beagleboard/robotics-cape/(threads)

Thread 2 (2021-11-23):

Header pin concerns

jadonk, 2021-11-23:
Reply here with any header pin concerns to consolidate them.

* P8_21/P8_33 have only PRU UART, not ARM UART, so a driver and firmware would need to be written.
* P8_24 does not have UART2 for GPS_RXD.

jadonk, 2021-12-21:
I am *SO* confused by the pin selection. It seems that the previous Robotics Cape pinout was completely missed and nothing could ever be compatible with BeagleBone Black.

https://github.com/beagleboard/capes/tree/master/beaglebone/Robotics

Thread 4 (2021-11-23):

4-pin connectors could be Grove

jadonk, 2021-11-23:
I thought we agreed the QEP and Ultrasonic connectors could be Grove. There's no good need for them to be small anymore with the new size of the board, so I think we can enlarge to Grove connectors.

Closed 2022-02-06.

Thread 5 (2021-11-23):

Schematic pin header numbers don't match BBAI

jadonk, 2021-11-23:
The pin numbers should be changed to match.

jadonk, 2022-02-06:
Please fix this.

Thread 6 (2021-11-23):

Cape EEPROM

jadonk, 2021-11-23:

linyuxuanlin, 2021-12-01:
scl, sda is re-used with Barometer_CS, SPI1_SDI. EEPROM I2C can not work.

Thread 10 (2021-12-01):

USB hub

linyuxuanlin, 2021-12-01:
USB can not enumerate peripherals. No pull-up resistor for USB hub dp.

jadonk, 2022-04-05:
Revision 0.6 also does not work.

jadonk, 2022-04-07:
The issue was with the particular AI-64 board.

Closed 2022-04-07.

Thread 12 (2021-12-01):

Misoperation protection

linyuxuanlin, 2021-12-01:
Add anti-reverse protection for battery connector.

Thread 13 (2021-12-01):

Motor silkscreen

linyuxuanlin, 2021-12-01:
Motor 2/3/4 silkscreen is wrong.

Thread 7 (2021-12-01):

Motor over-current protection

linyuxuanlin, 2021-12-01:
When motor 2/3/4 is over-current protected, it can not be reset. It needs nSleep signal for reset. But the schematic design do not have nSleep signal.

Thread 9 (2021-12-01):

USB power switch

linyuxuanlin, 2021-12-01:
Use the wrong USB power switch.

Thread 19 (2021-12-08):

eQEP doesn't work

mingzhangqun, 2021-12-08:
config:
https://github.com/mingzhangqun/BeagleBoard-DeviceTrees/commit/04c1ba7bc28e5279bef8331f263dd7f7e5487e15

test:
```
# QEP - enable
root@BeagleBone:# echo 312 > /sys/class/gpio/export
root@BeagleBone:# echo out > /sys/class/gpio/gpio312/direction
root@BeagleBone:# echo 0 > /sys/class/gpio/gpio312/value

root@BeagleBone:/sys/bus/counter/devices/counter0/count0# echo 1 > enable
root@BeagleBone:/sys/bus/counter/devices/counter0/count0# watch -n 0.1 cat count

root@BeagleBone:/sys/bus/counter/devices/counter1/count0# echo 1 > enable
root@BeagleBone:/sys/bus/counter/devices/counter1/count0# watch -n 0.1 cat count
```

I can't get the value of the counter when the motor is running.

Thread 20 (2022-01-05):

Pinout

jadonk, 2022-01-05:
Pinout would be much better if kept largely compatible with the previous Robotics Cape!!!

https://github.com/beagleboard/capes/tree/master/beaglebone/Robotics

jadonk, 2022-01-05:
The pins used on that board have compatible UART/PWM/I2C/SPI locations used across many BeagleBone boards. By choosing other locations for UART/PWM/I2C/SPI, much compatibility is broken. BeagleBone AI-64 header pins were chosen to match this board.

jadonk, 2022-01-05:
cc @mingzhangqun @linyuxuanlin

jadonk, 2022-04-05:
New pinout....

<google-sheets-html-origin><style type="text/css"><!--td {border: 1px solid #ccc;}br {mso-data-placement:same-cell;}--></style>

Function | Pin | IO Category | Compatible with BBB | Recommended header pin | BBB function | BBAI function
-- | -- | -- | -- | -- | -- | --
Motor1 | Motor1_PWM | PWM | NO | P9_14 | PWM | PWM
Motor1 | Motor1_IN1 | IO | YES（GPIO） | P9_13 | GPIO | GPIO
Motor1 | Motor1_IN2 | IO | YES（GPIO） | P8_08 | GPIO | GPIO
Motor1 | Motor1_SLP# | IO | YES（GPIO） | P8_45 | GPIO | GPIO
Motor1 | Motor1_FAULT# | IO | YES（GPIO） | P8_05 | Do not have function | GPIO
Motor1 | Motor1_OC# | IO | YES（GPIO） | P8_25 | Do not have function | GPIO
Motor1 | Motor1_CLMT | IO | YES（GPIO） | P8_21 | Do not have function | GPIO
Motor1 | Motor1_Current | AIN | YES | P9_40 | AIN | AIN
Motor2/3/4 | Motor2_PWM | PWM | NO | P9_16 | PWM | PWM
Motor2/3/4 | Motor2_IN1 | IO | YES（GPIO） | P8_18 | GPIO | GPIO
Motor2/3/4 | Motor2_IN2 | IO | YES（GPIO） | P9_18 | GPIO | GPIO
Motor2/3/4 | Motor2_IPROPI | AIN | YES | P9_33 | AIN | AIN
Motor2/3/4 | Motor2_FAULT# | IO | YES（GPIO） | P8_22 | Do not have function | GPIO
Motor2/3/4 | Motor3_PWM | PWM | NO | P8_19 | PWM | PWM
Motor2/3/4 | Motor3_IN1 | IO | YES（GPIO） | P8_10 | GPIO | GPIO
Motor2/3/4 | Motor3_IN2 | IO | YES（GPIO） | P8_12 | GPIO | GPIO
Motor2/3/4 | Motor3_IPROPI | AIN | YES | P9_35 | AIN | AIN
Motor2/3/4 | Motor3_FAULT# | IO | YES（GPIO） | P8_23 | Do not have function | GPIO
Motor2/3/4 | Motor4_PWM | PWM | NO | P8_13 | PWM | PWM
Motor2/3/4 | Motor4_IN1 | IO | YES（GPIO） | P8_17 | GPIO | GPIO
Motor2/3/4 | Motor4_IN2 | IO | YES（GPIO） | P8_26 | GPIO | GPIO
Motor2/3/4 | Motor4_IPROPI | AIN | YES | P9_36 | AIN | AIN
Motor2/3/4 | Motor4_FAULT# | IO | YES（GPIO） | P8_03 | Do not have function | GPIO
Motor2/3/4 | Motor2/3/4_nSLEEP | IO | YES（GPIO） | P8_34 | GPIO | GPIO
LED | LED1 | IO | YES（GPIO） | P9_12 | GPIO | GPIO
LED | LED2 | IO | YES（GPIO） | P9_11 | GPIO | GPIO
LED | LED3 | IO | YES（GPIO） | P8_46 | GPIO | GPIO
LED | LED4 | IO | YES（GPIO） | P8_31 | GPIO | GPIO
BC | BC_TXD | UART | NO | P8_37 | UART_TX | UART_TX
BC | BC_RXD | UART | NO | P8_38 | UART_RX | UART_RX
BC | BC_RST | IO | YES（GPIO） | P8_32 | GPIO | GPIO
CAPTURE | CAP1 | ECAP | YES | P8_16 | PRU0_IN | PRU0_0_IN
CAPTURE | CAP2 | ECAP | YES | P8_15 | PRU0_IN | PRU0_0_IN
CAPTURE | CAP3 | ECAP | YES | P9_28 | PRU0_IN | PRU0_0_IN
CAPTURE | CAP4 | ECAP | YES | removed | \ | \
CAPTURE | CAP_OE1# | IO | YES（GPIO） | P9_15 | GPIO | GPIO
QEP | QEP1_A | EQEP | YES | P9_42 | QEP_A |  
QEP | QEP1_B | EQEP | YES | P9_27 | QEP_B |  
QEP | QEP2_A | EQEP | YES | P8_35 | QEP_A |  
QEP | QEP2_B | EQEP | YES | P8_33 | QEP_B |  
QEP | CAP_OE2# | IO | YES（GPIO） | removed | \ | \
Ultrasonic | Ultrasonic1 | IO | YES（GPIO） | P8_11 | GPIO | GPIO
Ultrasonic | Ultrasonic2 | IO | YES（GPIO） | P8_09 | GPIO | GPIO
Ultrasonic | Ultrasonic3 | IO | YES（GPIO） | P9_38 | GPIO | GPIO
Ultrasonic | Ultrasonic4 | IO | YES（GPIO） | P8_36 | GPIO | GPIO
Lidar | Lidar_PWM | PWM | NO | P8_07 | TIMER | PRU1_0_OUT
Lidar | Lidar_OE | IO | YES（GPIO） | P8_14 | GPIO | GPIO
Lidar | Lidar_TX | UART | NO | P9_21 | UART_TX | PRU1_1_OUT (soft UART)
Lidar | Lidar_RX | UART | NO | P9_22 | UART_RX | PRU1_1_IN (soft uart)
Servo | Servo1 | PWM | YES | P8_27 | PRU1_OUT | PRU0_0_OUT
Servo | Servo2 | PWM | NO | P8_28 | PRU1_OUT | PRU0_0_OUT
Servo | Servo3 | PWM | YES | P8_29 | PRU1_OUT | PRU0_0_OUT
Servo | Servo4 | PWM | NO | P8_30 | PRU1_OUT | PRU0_0_OUT
Servo | Servo5 | PWM | NO | P8_39 | PRU1_OUT | PRU0_1_OUT
Servo | Servo6 | PWM | NO | P8_40 | PRU1_OUT | PRU0_1_OUT
Servo | Servo7 | PWM | NO | P8_41 | PRU1_OUT | PRU0_1_OUT
Servo | Servo8 | PWM | NO | P8_42 | PRU1_OUT | PRU0_1_OUT
Servo | Servo9 | PWM | NO | P8_43 | PRU1_OUT | PRU0_1_OUT
Servo | Servo10 | PWM | NO | P8_44 | PRU1_OUT | PRU0_1_OUT
6-DOF Sensor(SPI) | 6DOF_CS# | IO | YES（GPIO） | P9_23 | GPIO | GPIO
6-DOF Sensor(SPI) | 6DOF_INT | IO | YES（GPIO） | P8_24 | Do not have function | GPIO
Compass(SPI) | CPSS_CS# | IO | YES（GPIO） | P9_25 | GPIO | GPIO
Compass(SPI) | CPSS_INT | IO | YES（GPIO） | P8_06 | Do not have function | GPIO
Barometer(SPI) | Barometer_CS# | IO | YES | P9_17 | GPIO | GPIO
SPI | SPI1_SCK | SPI | YES | P9_31 | SPI_SCK | SPI_SCK
SPI | SPI1_SDO | SPI | YES | P9_30 | SPI_MOSI | SPI_MOSI
SPI | SPI1_SDI | SPI | YES | P9_29 | SPI_MISO | SPI_MISO
USB_HUB | USB_HUB_D_P | USB | YES | \ | \ | \
USB_HUB | USB_HUB_D_N | USB | YES | \ | \ | \
USB_HUB | RESETSTATZ | USB | YES | P9_10 | RESET | RESET
USER_BUTTON | USER_BUTTON1 | IO | YES | P9_37 | GPIO | GPIO
USER_BUTTON | USER_BUTTON2 | IO | YES（GPIO） | P9_41 | GPIO | GPIO
GPS | GPS_TXD | UART | NO | P9_24 | UART_TX | UART_TX
GPS | GPS_RXD | UART | NO | P9_26 | UART_RX | UART_RX
Battery_Voltage | Battery_Voltage | AIN | YES | P9_39 | AIN | AIN
EEPROM | EEPROM_SCL | I2C | YES | P9_19 | I2C_SCL | I2C_SCL
EEPROM | EEPROM_SDA | I2C | YES | P9_20 | I2C_SDA | I2C_SDA

Thread 21 (2022-02-02):

Car: Need clearance for superspeed USB sticks

jadonk, 2022-02-02:
The front-facing ultrasonic sensor must be removed to reach the USB connectors for a typical sized superspeed USB stick. This will be used for gathering training data to the main computer.

Possible solutions:
* Perhaps the AI-64/cape sub-assembly can be rotated 90 degrees? If so, access to the buttons and status LEDs within the enclosure is desired.
* Perhaps the front-facing ultrasonic sensor could be snap-mounted for easy removal?

Thread 22 (2022-02-02):

Car: cover for AI-64 5V DC input

jadonk, 2022-02-02:
An insert on the AI-64 5V DC input should be provided to avoid accidentally connecting the 12V supply to the wrong jack.

Additionally, a 12V label should be put on the Robotics Cape similar to the 5V label on the AI-64.

jadonk, 2022-04-07:
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

Thread 25 (2022-02-06):

LED1 should be green

jadonk, 2022-02-06:

lorforlinux, 2022-10-11:
Shouldn't this be red for indicating 25%?

|        Indicator      | Battery %  |  Color |
|------------|--------------|---------|
| LED1    | 25%         | Red   |
| LED2    | 50%         | Green   |
| LED3    | 75%         | Green   |
| LED4    | 100%         | Green   |

jadonk, 2022-10-12:
I think you are right. The idea of charlieplexing is good with pru firmware
and a linux leds driver.

On Tue, Oct 11, 2022 at 4:25 PM Deepak Khatri ***@***.***>
wrote:

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

Thread 26 (2022-02-06):

LED3 should be lableled "25%"

jadonk, 2022-02-06:
This is used a the battery 25% indicator.

Please see https://github.com/beagleboard/capes/tree/master/beaglebone/Robotics that this cape replaces.

Thread 27 (2022-02-06):

LED4 should be labled "75%" and should be green

jadonk, 2022-02-06:
This led is used at the battery 75% full indicator.

Ideally, there would be 50% and 100% indicators as well, but we seem to be out of I/O pins.

See https://github.com/beagleboard/capes/tree/master/beaglebone/Robotics that this cape replaces.

jadonk, 2022-10-12:
Yes, simply due to a lack of LEDs. Your idea of charlieplexing is good, but
we should do a PRU firmware load for that and an associated leds driver.

On Tue, Oct 11, 2022 at 4:50 PM Deepak Khatri ***@***.***>
wrote:

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

Thread 28 (2022-02-06):

Need UART connections for BCF_RXD/BCF_TXD

jadonk, 2022-02-06:
The last revision worked, but the latest revision has the pins connected to only a PRU UART. That cannot work. They need to be on a main or wakeup UART.

Please prefer connections specified by https://elinux.org/Beagleboard:BeagleBone_cape_interface_spec#UART.

jadonk, 2022-02-06:
Ugh. I just realized the pins are still labeled wrong. I'll start my overlay over again.

lorforlinux, 2022-10-11:
@jadonk This seems to be fixed with v0.7 of the cape.
Current board uses `/dev/bone/uart/5` pins from our cape compatibility layer.

Thread 29 (2022-02-07):

Motor2_PWM can't control

mingzhangqun, 2022-02-07:
PRU firmware:
https://github.com/mingzhangqun/cloud9-examples/tree/bbai64-cape
DTS:
https://github.com/mingzhangqun/BeagleBoard-DeviceTrees/tree/v5.10.x-ti-arm64-dev
robotic_demo:
https://github.com/mingzhangqun/robotic_demo/tree/main-dev

```
debian@BeagleBone:~/cloud9-examples/BeagleBone/AI-64/pru$ sudo make blinkR30
```
```
debian@BeagleBone:~/robotic_demo$ make
Please select pwm chs[0-14]:(0,1,2,3...)
1
Selected:0x0002
('q' - exit, '+' - inc, '-' - dec, 'r' - run/stop)
sh: 1: echo: echo: I/O error
sh: 1: echo: echo: I/O error
sh: 1: echo: echo: I/O error
+
duty=100
r
ctrl=1
```
Motor2 PWM cannot be controlled, other channels are fine.

jadonk, 2022-02-08:
Is the 0.6 version of the schematics the latest? I'm not understanding some of the behavior myself, including something as simple as controlling LED1 and LED2.

mingzhangqun, 2022-02-08:
> Is the 0.6 version of the schematics the latest? I'm not understanding some of the behavior myself, including something as simple as controlling LED1 and LED2.

Yes, the 0.6 is the latest.
What's your meaning of the behavior? the hardware or software?

jadonk, 2022-02-08:
I cannot toggle LED1 and LED2 signals. I have a boot issue now, but hope to resolve that this morning.

mingzhangqun, 2022-02-09:
```
root@BeagleBone:/sys/class/leds# echo 1 > beaglebone\:green\:cape0/brightness
root@BeagleBone:/sys/class/leds# echo 1 > beaglebone\:green\:cape1/brightness
root@BeagleBone:/sys/class/leds# echo 1 > beaglebone\:green\:cape2/brightness
root@BeagleBone:/sys/class/leds# echo 1 > beaglebone\:green\:cape3/brightness
```

jadonk, 2022-02-11:
I meant LED1/LED2 on the cape. I fixed it with recent patches at https://github.com/jadonk/BeagleBoard-DeviceTrees/tree/ai64

I'm going to try Motor2 again soon (probably tomorrow morning), but I wanted to try to understand why my interface had issues. I had forgotten that PIN_OUTPUT in the device tree simply disables the input. It seems it also had some impact on being able to configure for gpio output as well somehow. I'm trying to determine if there was a conflict driven or a lack of GPIO enabled on one of your pins needed for Motor2.
