beagleboard/robotics-cape/Cape V0.6/Robotics Cape Rev2 v0.6..pdf

# Aug. 16 2021

# REVISION

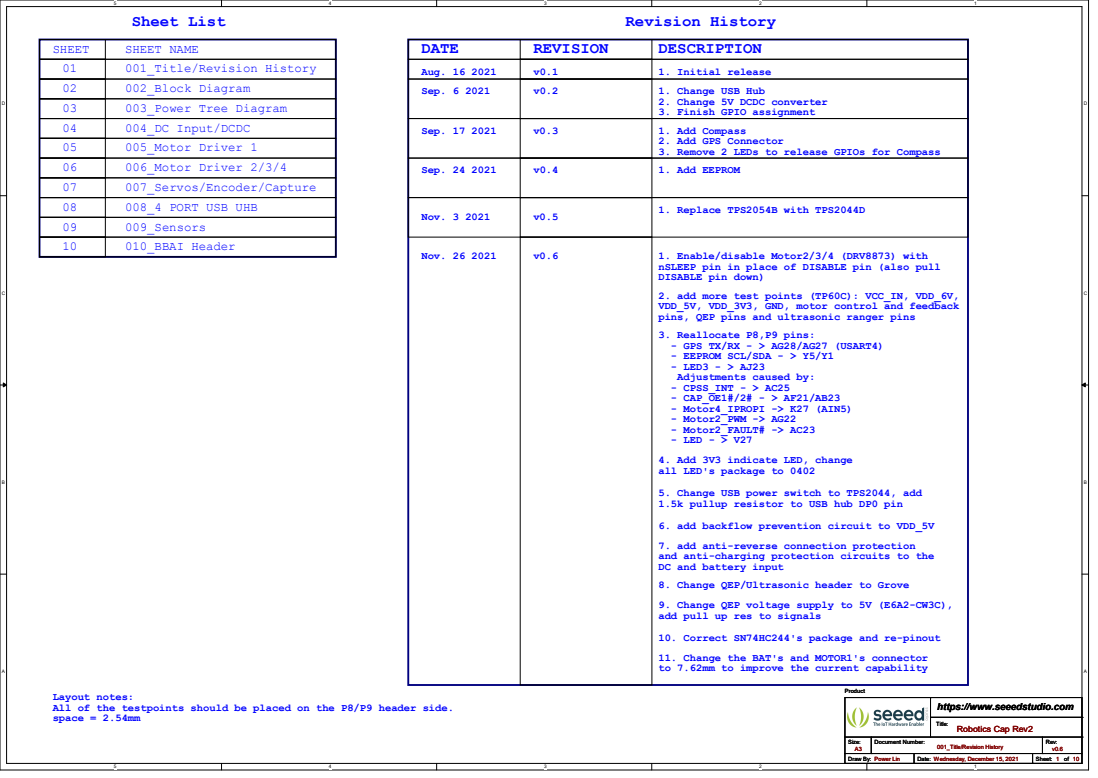
[picture p1: page 1]
DESCRIPTION; 1. Initial release; DATE; Revision History; SHEET; SHEET NAME; Sheet List; 07 08 09 009_Sensors 10 010_BBAI Header; Sep. 6 2021; 1. Change USB Hub; Sep. 17 2021; 1. Add Compass; Sep. 24 2021; 1. Add EEPROM v0.4; Nov. 3 2021; 1. Replace TPS2054B with TPS2044D; Nov. 26 2021; 1. Enable/disable Motor2/3/4 (DRV8873) with; to 7.62mm to improve the current capability; Title: Size:; Document Number:; Rev: Draw By:; Date:; Sheet:; https://www.seeedstudio.com A3; v0.6 Power Lin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

001_Title/Revision History
002_Block Diagram
003_Power Tree Diagram
004_DC Input/DCDC
005_Motor Driver 1
006_Motor Driver 2/3/4
007_Servos/Encoder/Capture
008_4 PORT USB UHB

2. Change 5V DCDC converter
3. Finish GPIO assignment

2. Add GPS Connector
3. Remove 2 LEDs to release GPIOs for Compass

nSLEEP pin in place of DISABLE pin (also pull
DISABLE pin down)
2. add more test points (TP60C): VCC_IN, VDD_6V,
VDD_5V, VDD_3V3, GND, motor control and feedback
pins, QEP pins and ultrasonic ranger pins
3. Reallocate P8,P9 pins:
- GPS TX/RX - > AG28/AG27 (USART4)
- EEPROM SCL/SDA - > Y5/Y1
- LED3 - > AJ23
Adjustments caused by:
- CPSS_INT - > AC25
- CAP_OE1#/2# - > AF21/AB23
- Motor4_IPROPI -> K27 (AIN5)
- Motor2_PWM -> AG22
- Motor2_FAULT# -> AC23
- LED - > V27
4. Add 3V3 indicate LED, change
all LED's package to 0402

5. Change USB power switch to TPS2044, add
1.5k pullup resistor to USB hub DP0 pin

6. add backflow prevention circuit to VDD_5V
7. add anti-reverse connection protection
and anti-charging protection circuits to the
DC and battery input
8. Change QEP/Ultrasonic header to Grove
9. Change QEP voltage supply to 5V (E6A2-CW3C),
add pull up res to signals

10. Correct SN74HC244's package and re-pinout
11. Change the BAT's and MOTOR1's connector

Layout notes:
All of the testpoints should be placed on the P8/P9 header side.
space = 2.54mm

001_Title/Revision History Product

# System Block Diagram

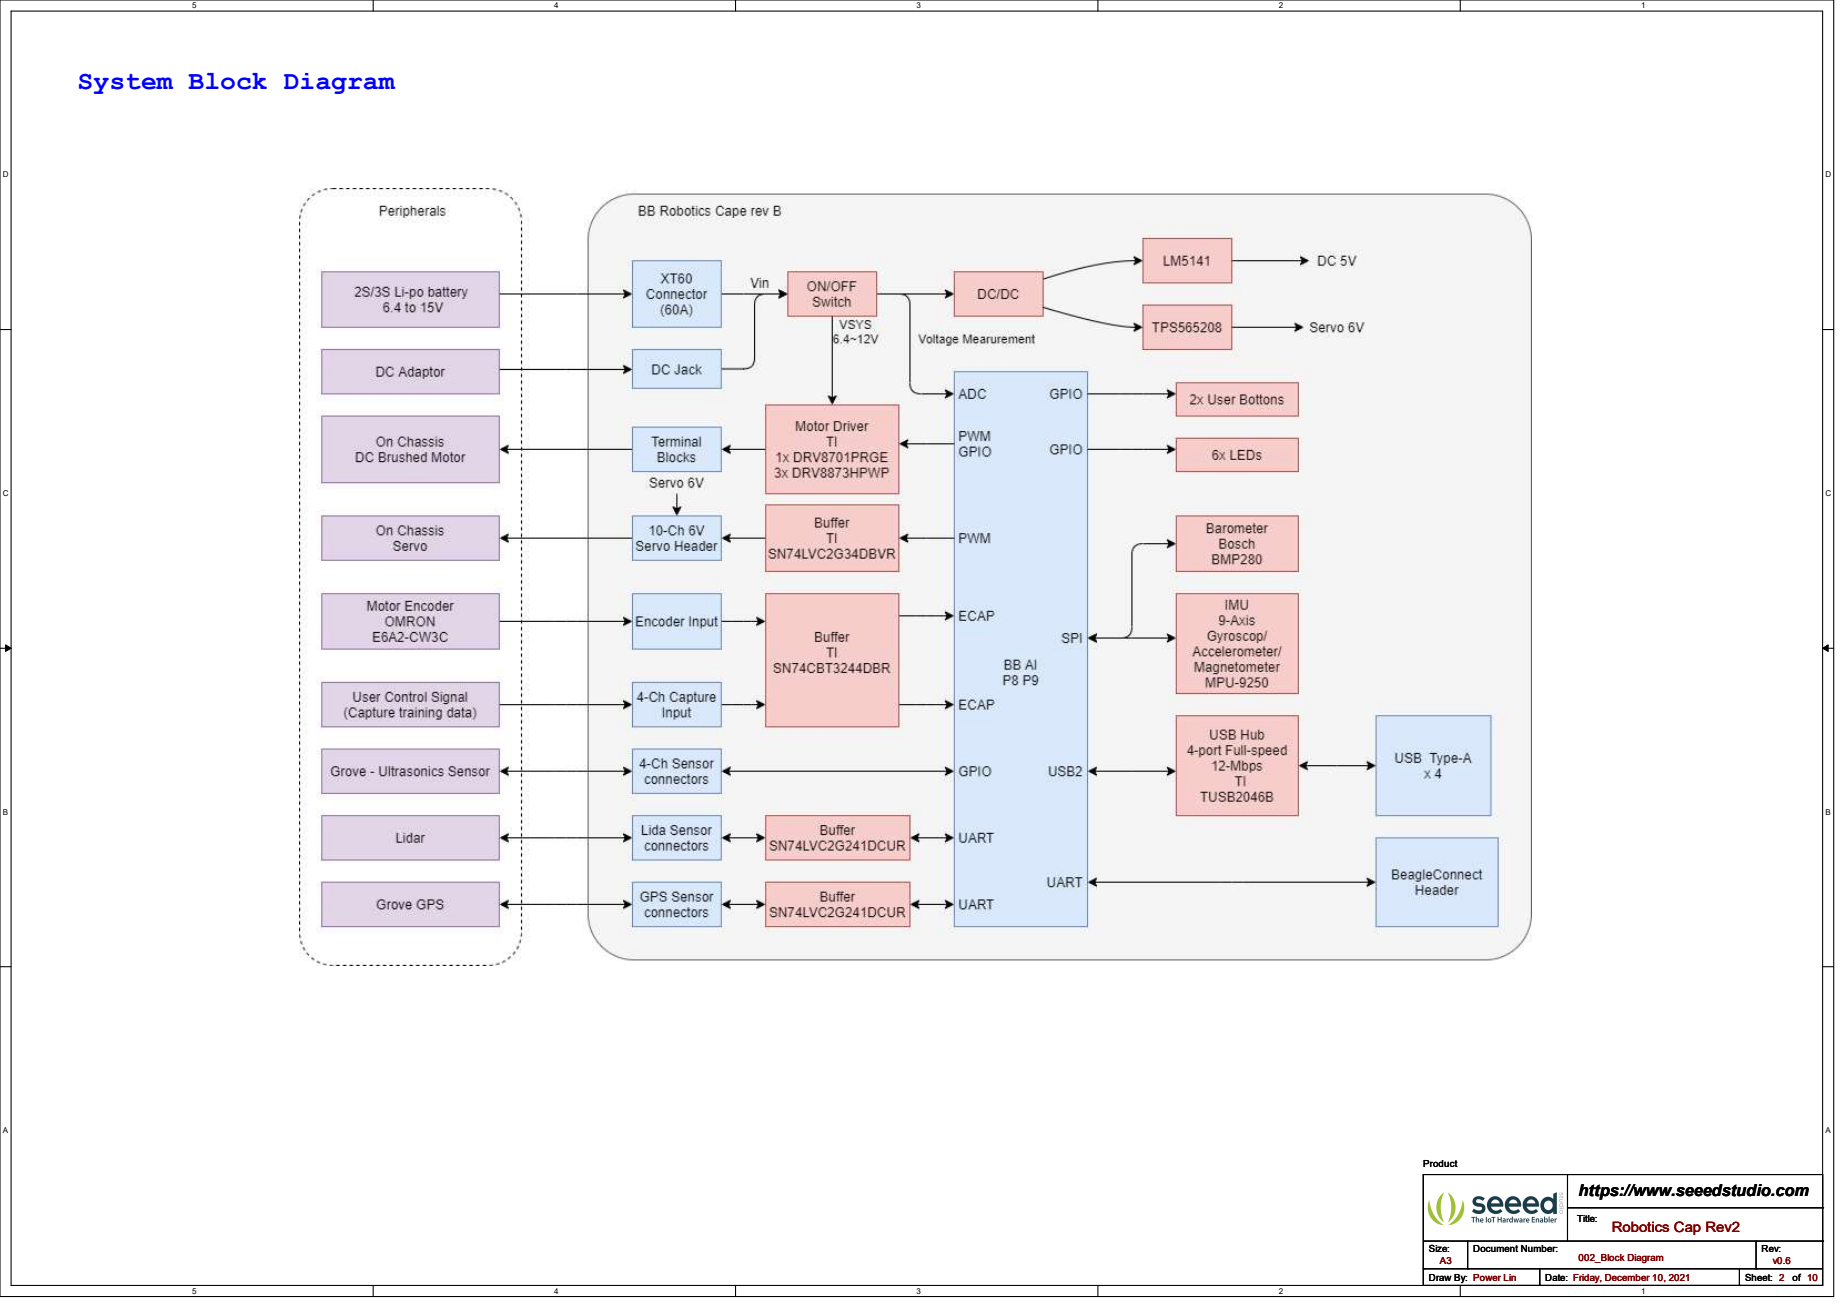
[picture p2: page 2]
Title: Size:; Document Number:; Rev: Draw By:; Date:; Sheet:; https://www.seeedstudio.com A3; v0.6 Power Lin; Friday, December 10, 2021; 10 Robotics Cap Rev2; 002_Block Diagram; Product

# Power tree

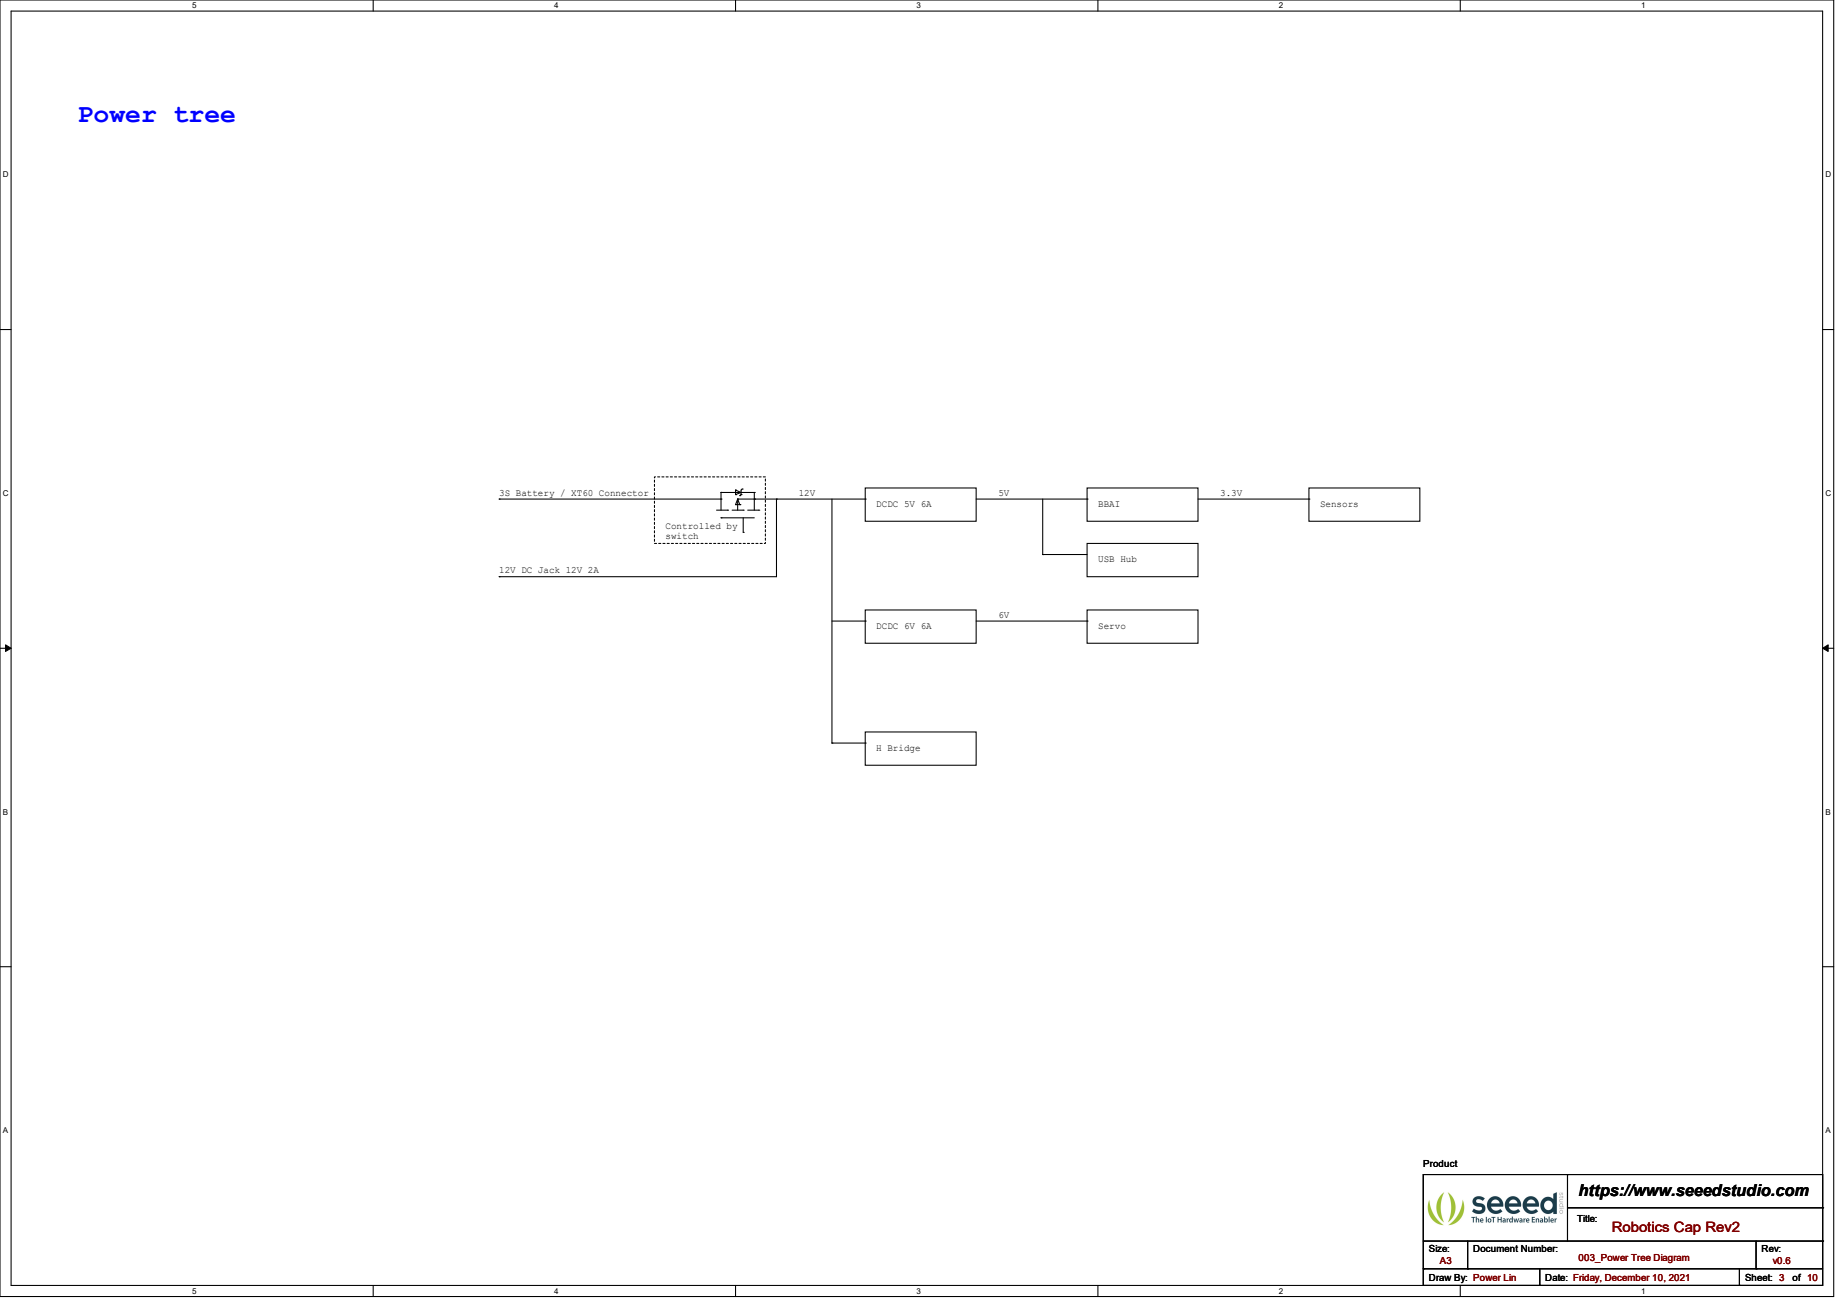
[picture p3: page 3]
12V DC Jack; 3S Battery / XT60 Connector; DCDC 5V 6A; DCDC 6V 6A; Controlled by switch; BBAI; Servo; H Bridge; Sensors; USB Hub; https://www.seeedstudio.com A3; v0.6 Power Lin; Friday, December 10, 2021; 10 Robotics Cap Rev2; 003_Power Tree Diagram; Product; Title: Size:; Document Number:; Rev: Draw By:; Date:; Sheet:

# DC AND BATTERY INPUT SELECT Unpluged: GND

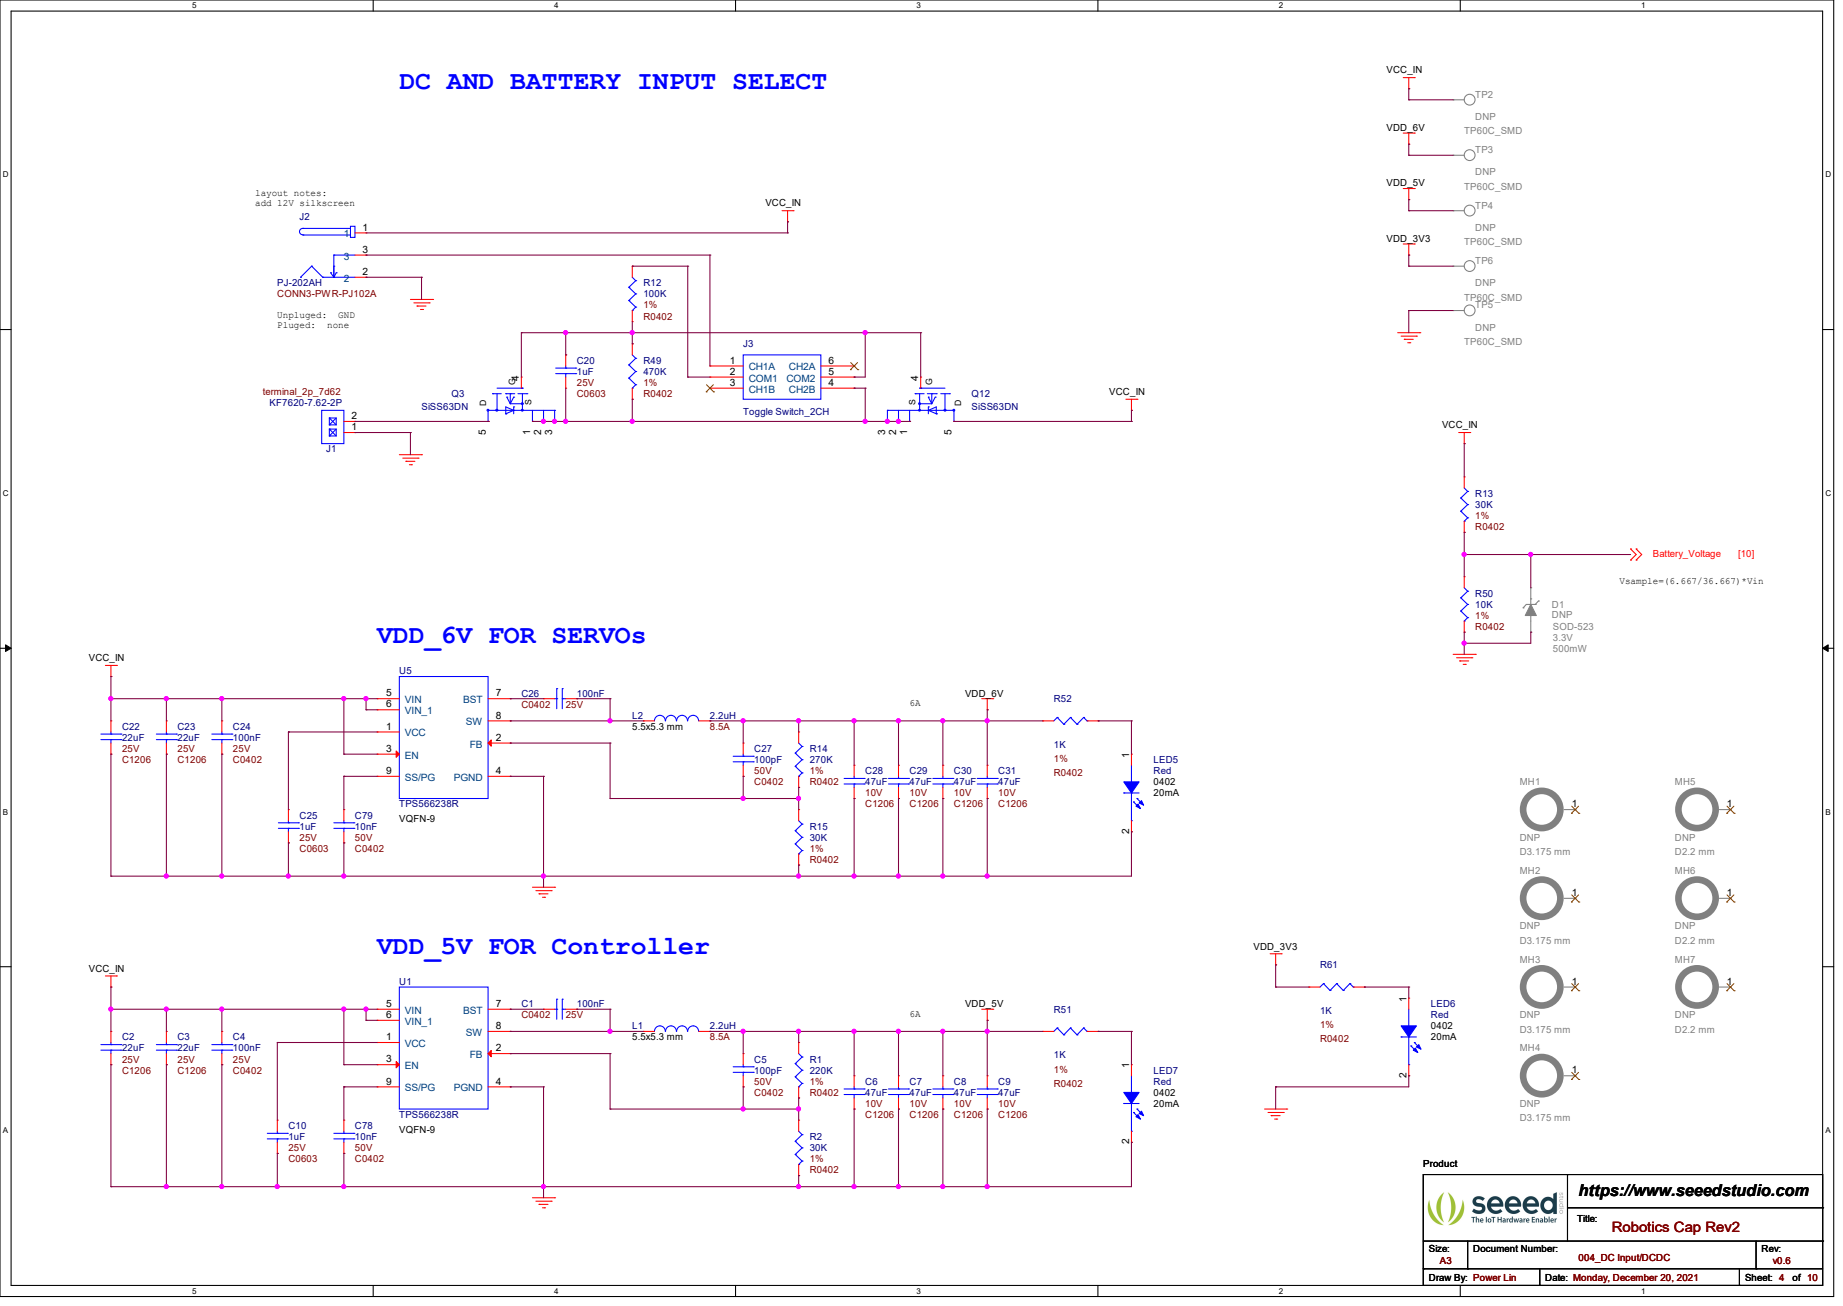
[picture p4: page 4]

MOTOR DRIVER 1 | VCC_IN

# 4 NC 5 VCC 6 TP12 DNP

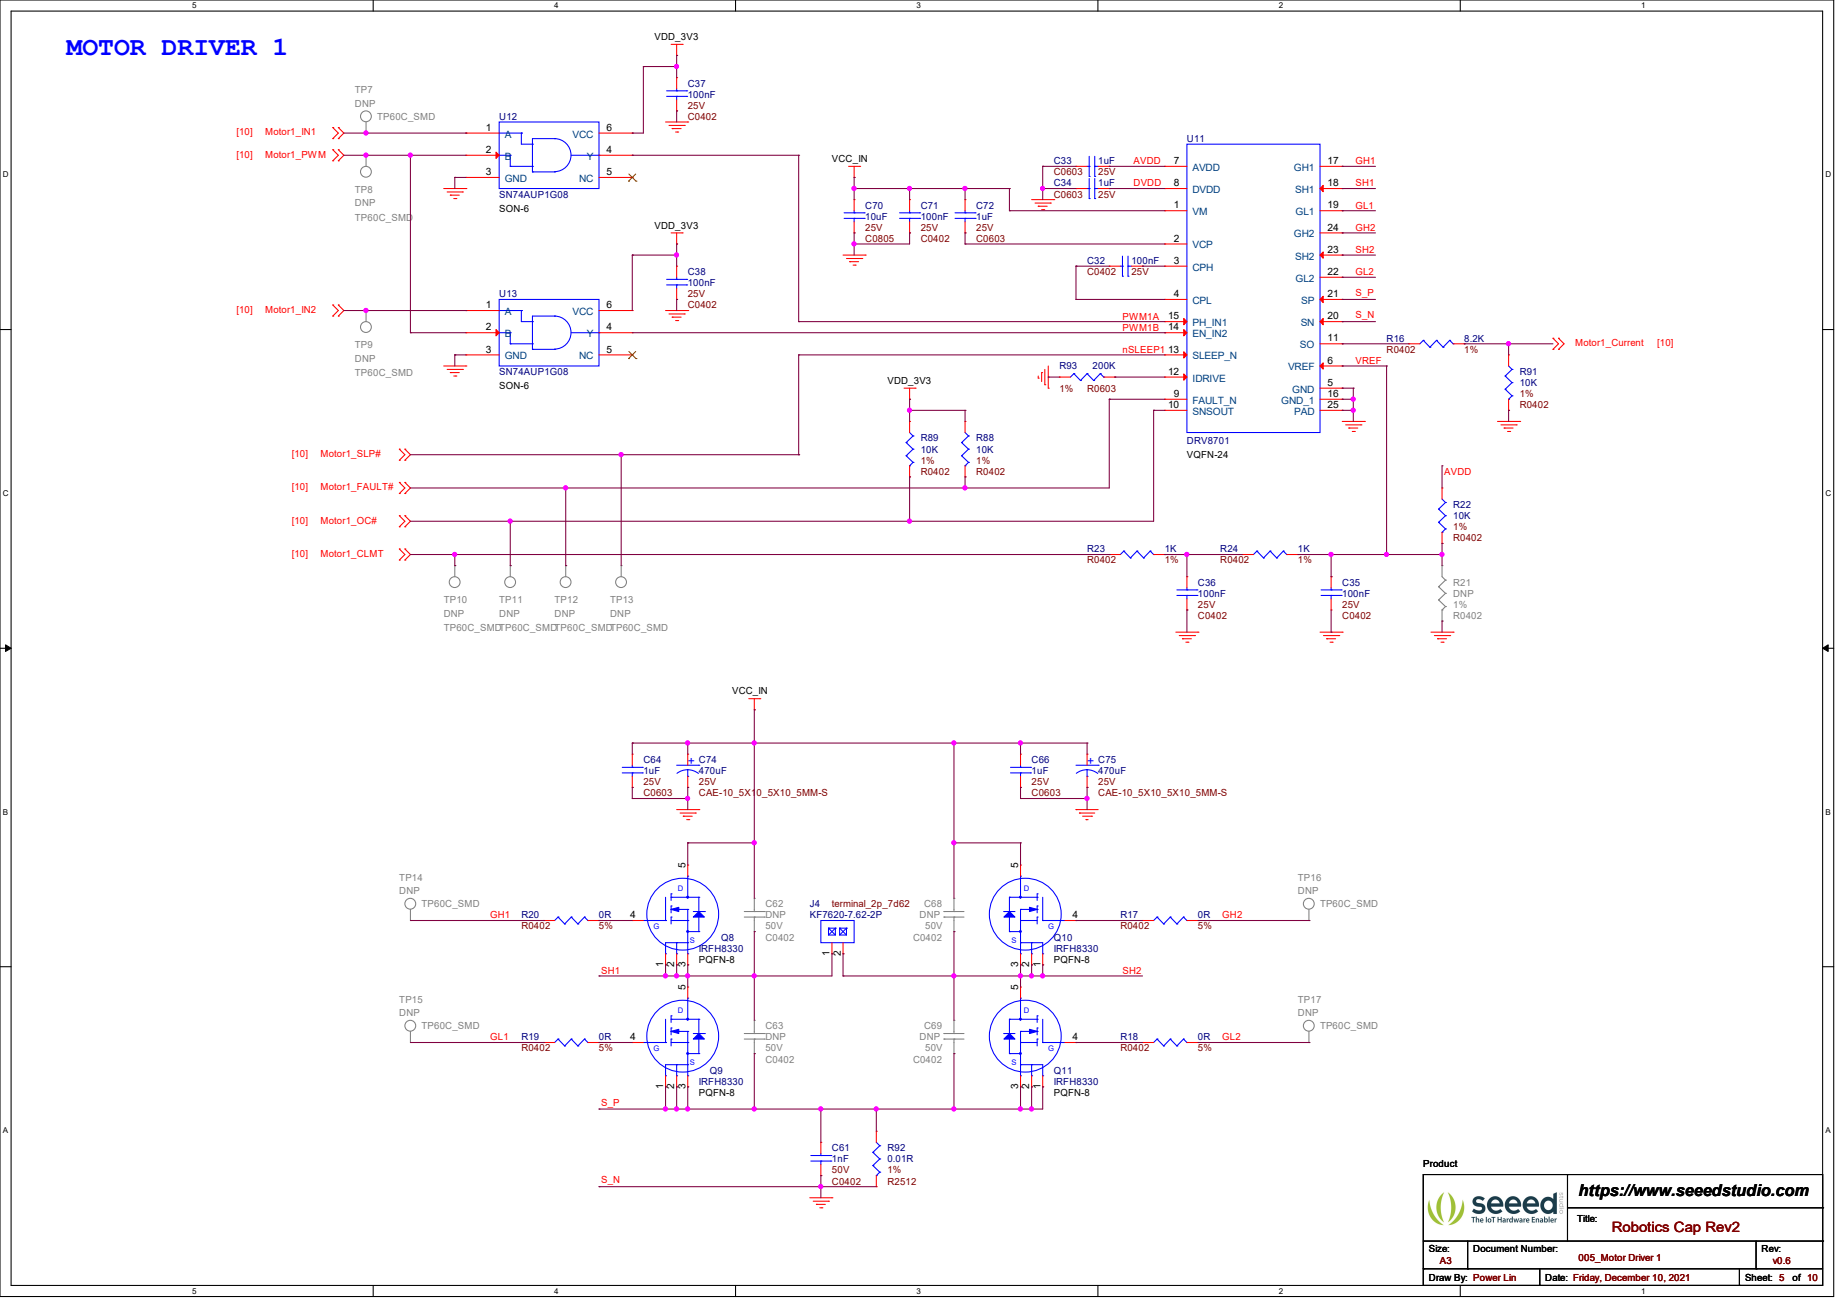
[picture p5: page 5]

# MOTOR DRIVER 2

# VDD_3V3 VDD_3V3

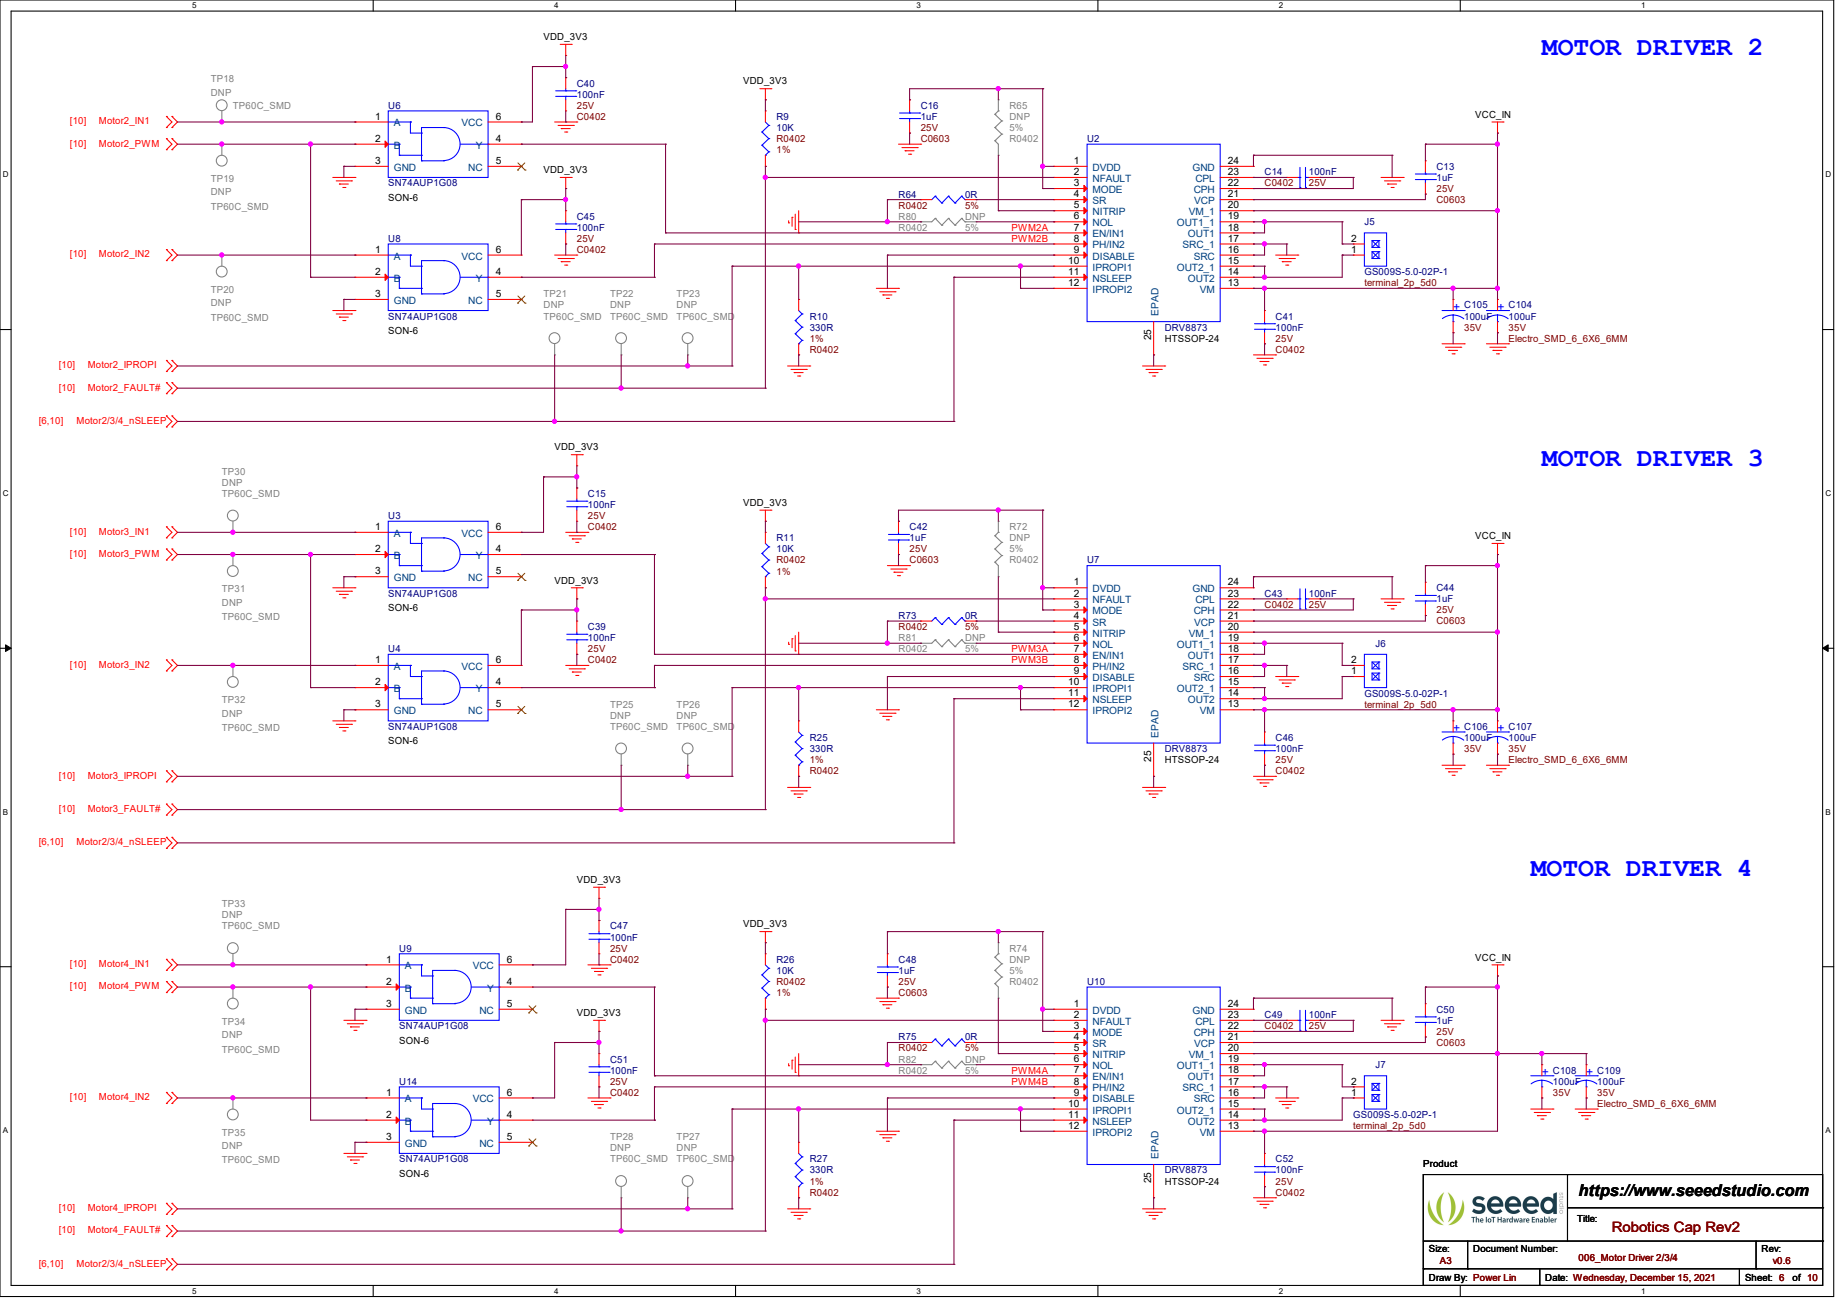
[picture p6: page 6]

# SERVOs HEADER

# CAPTURE INPUT HEADER

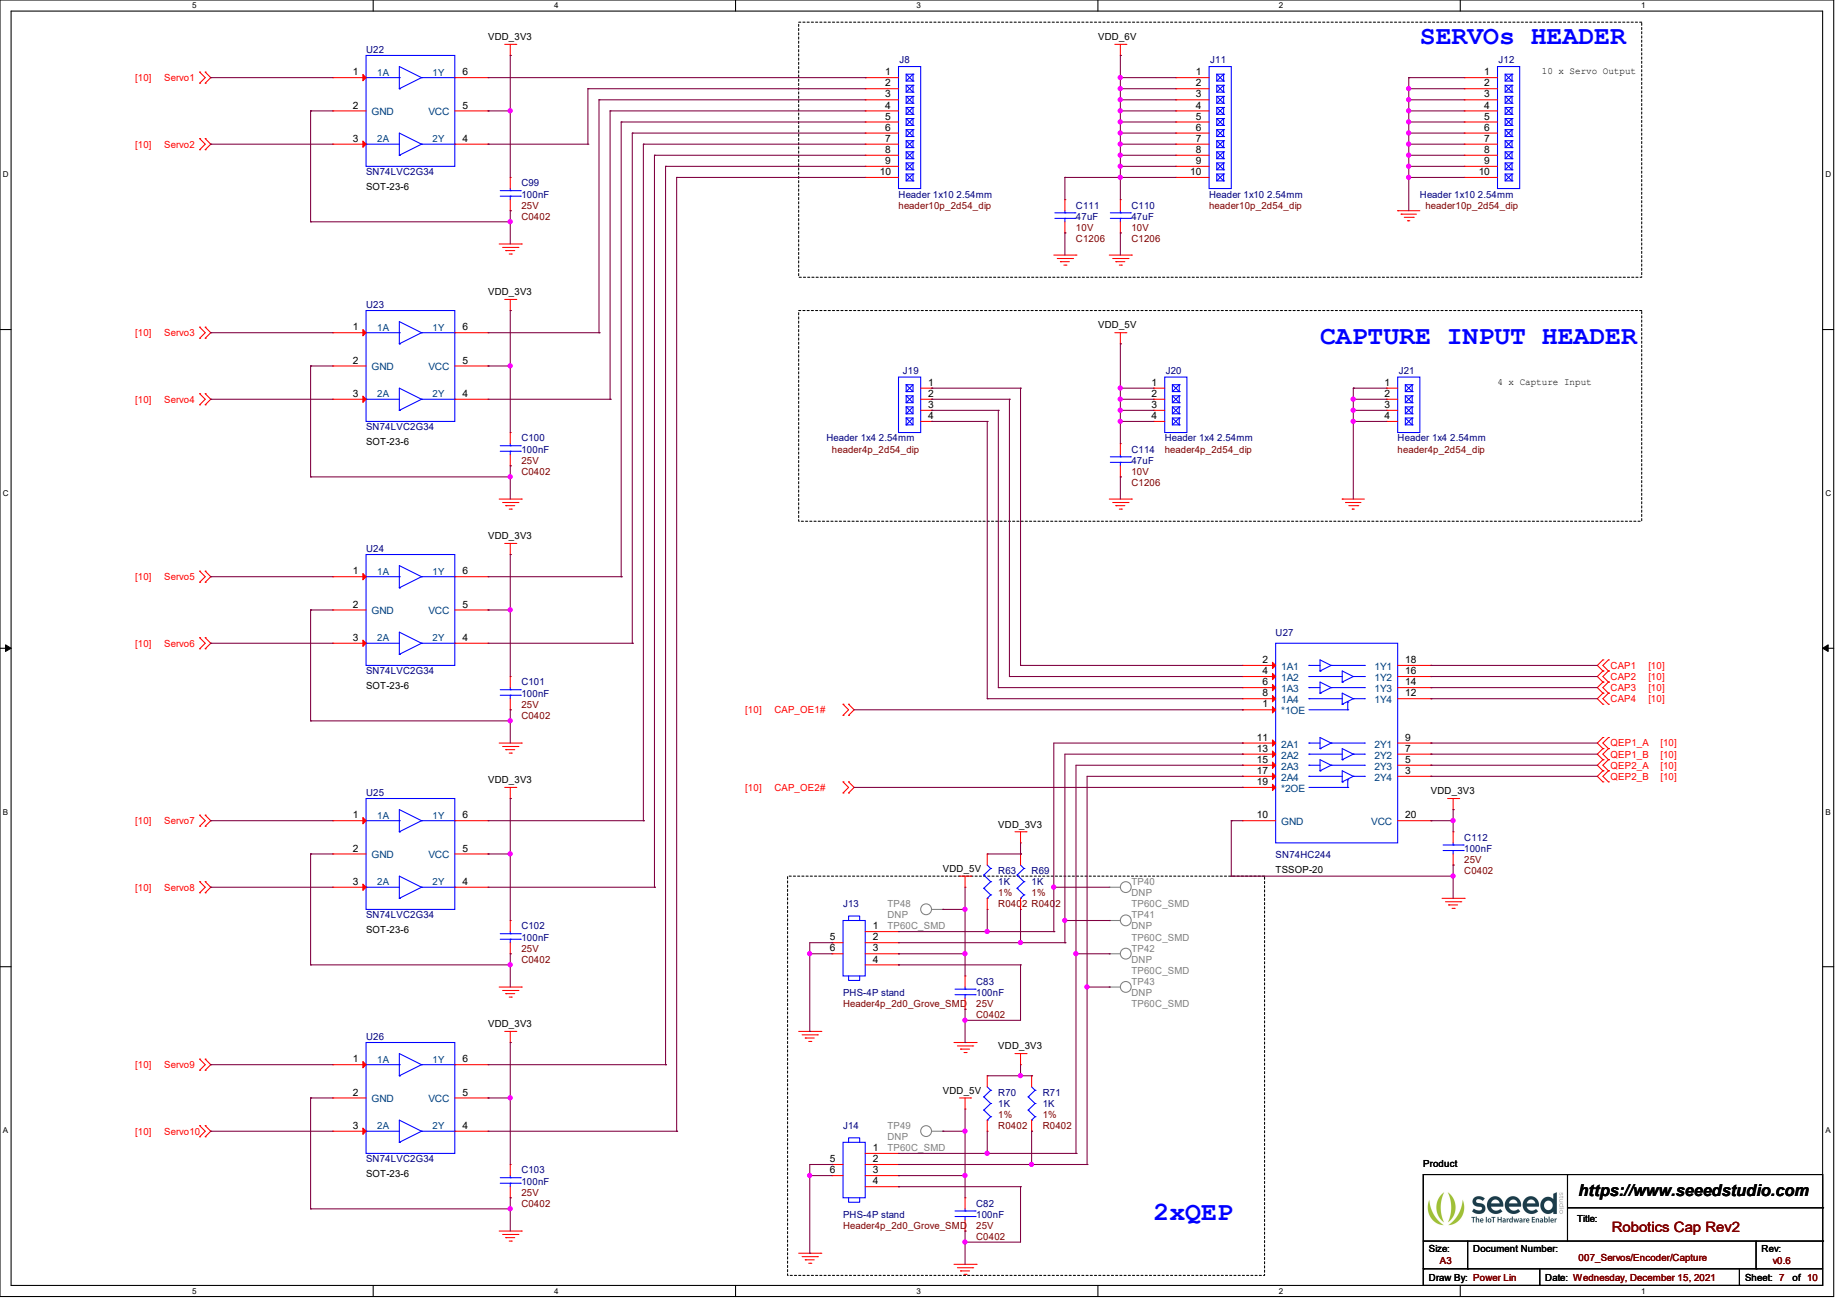
[picture p7: page 7]

# VDD_3V3 VDD_3V3

# R0402 U21 TPS2044D

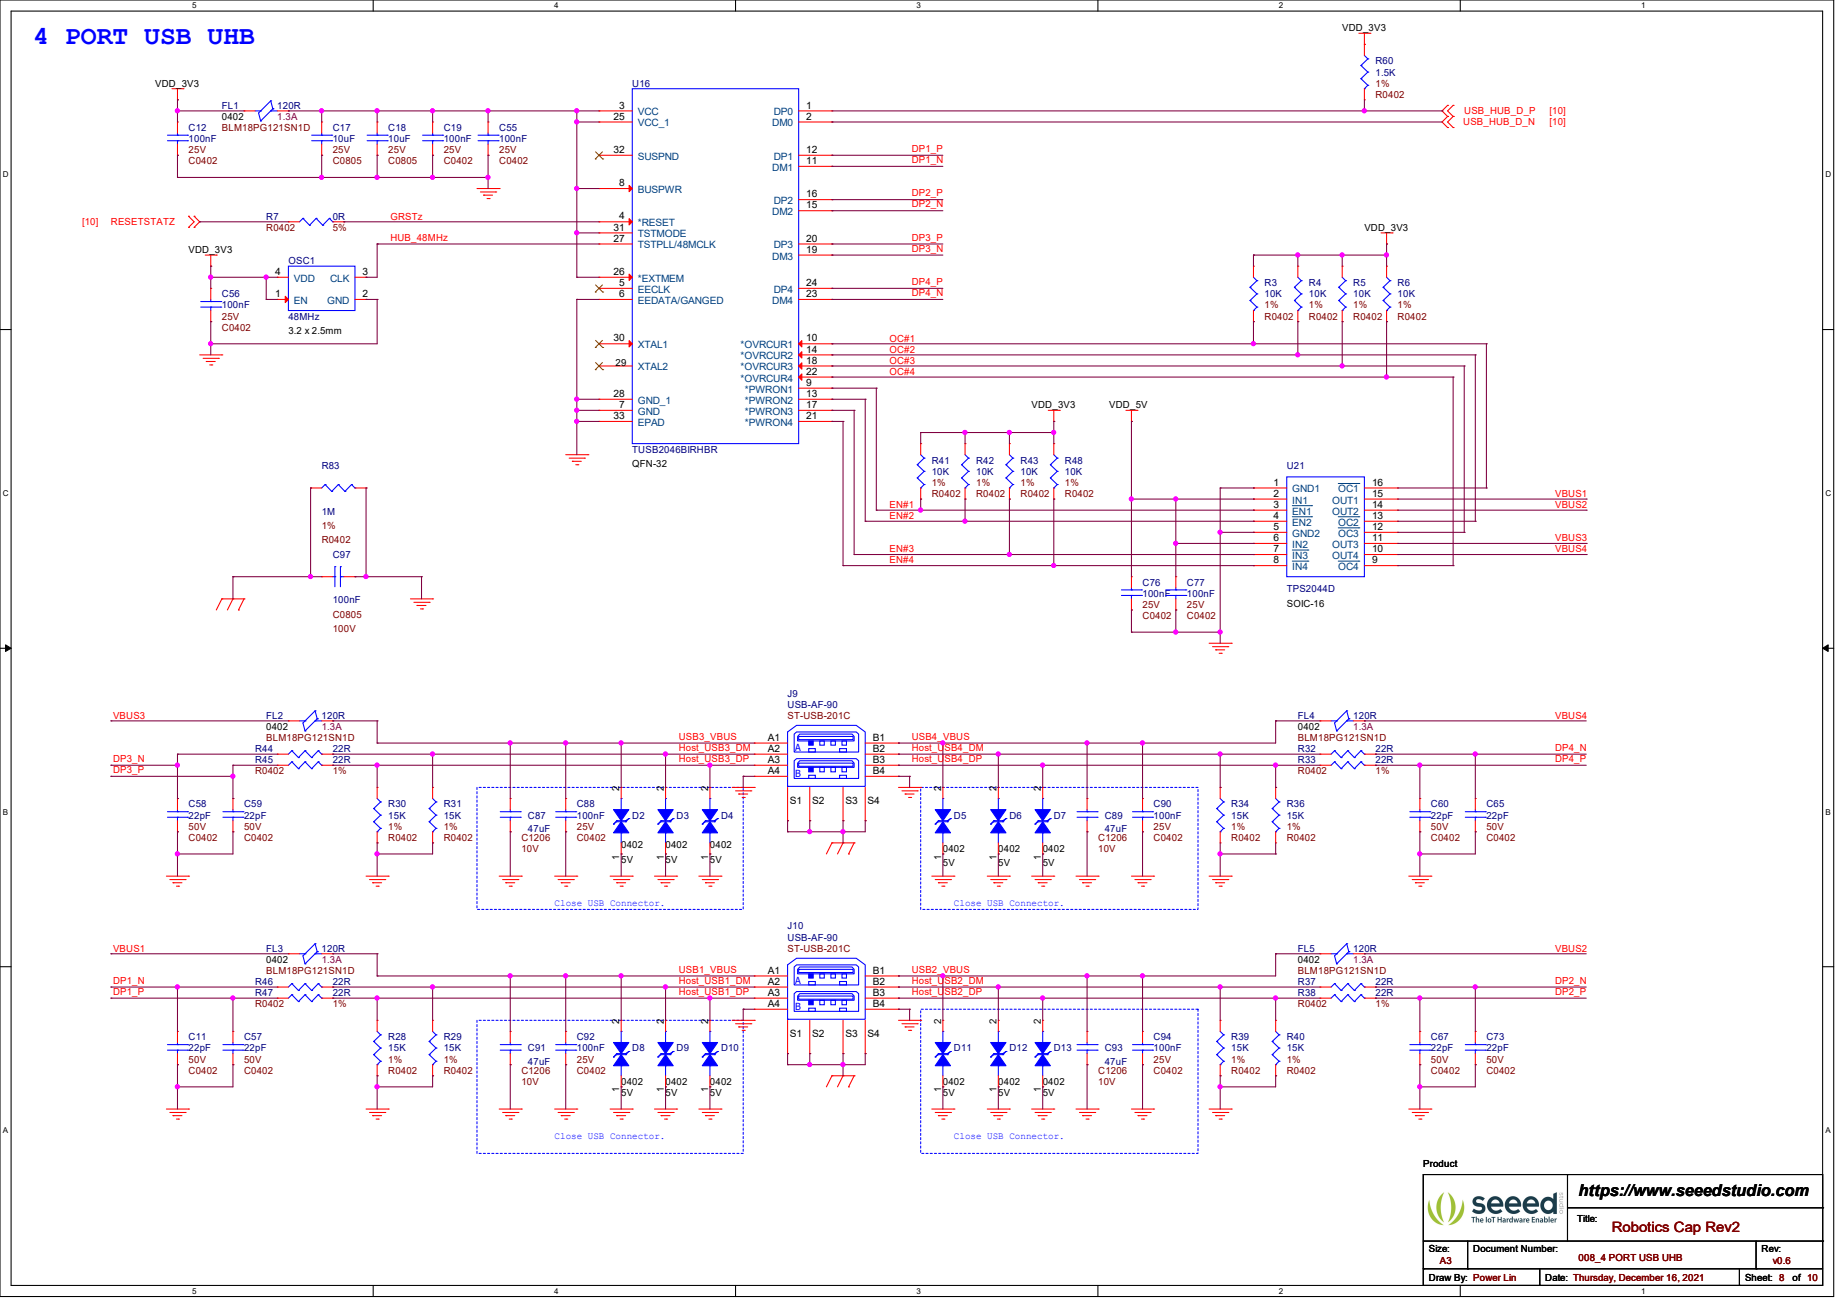
[picture p8: page 8]

VCC 3 GND 7
*EXTMEM 26 BUSPWR 8 EEDATA/GANGED 6 TSTMODE 31 TSTPLL/48MCLK 27 EECLK 5 SUSPND 32 VCC_1 25 GND_1 28

B J10 USB-AF-90 ST-USB-201C

# Barometer

# Lidar Interface

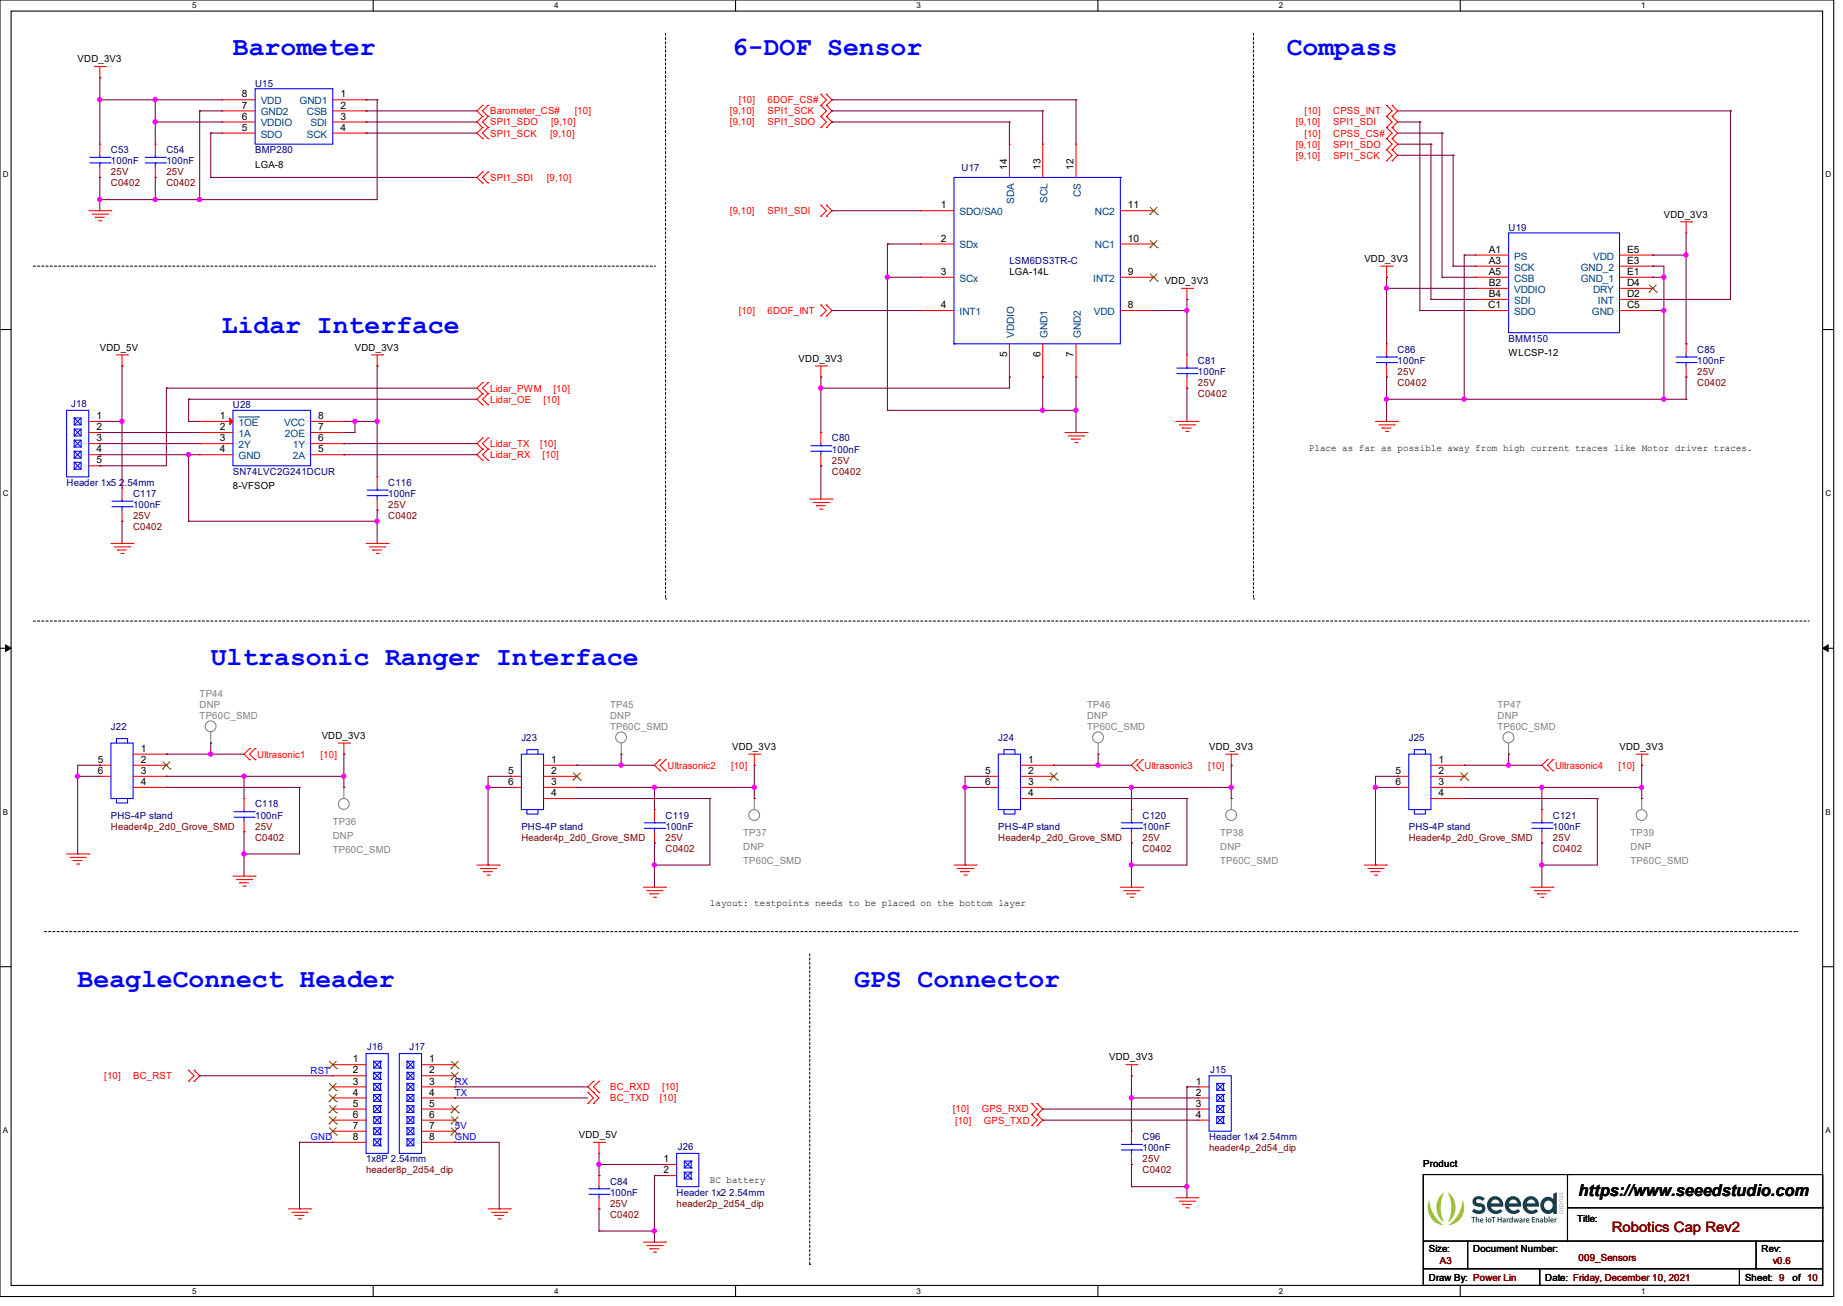
[picture p9: page 9]

Place as far as possible away from high current traces like Motor driver traces.

layout: testpoints needs to be placed on the bottom layer

EXPANSION HEADER P8 | EXPANSION HEADER P9

# P9 Male 2x25 2.54mm

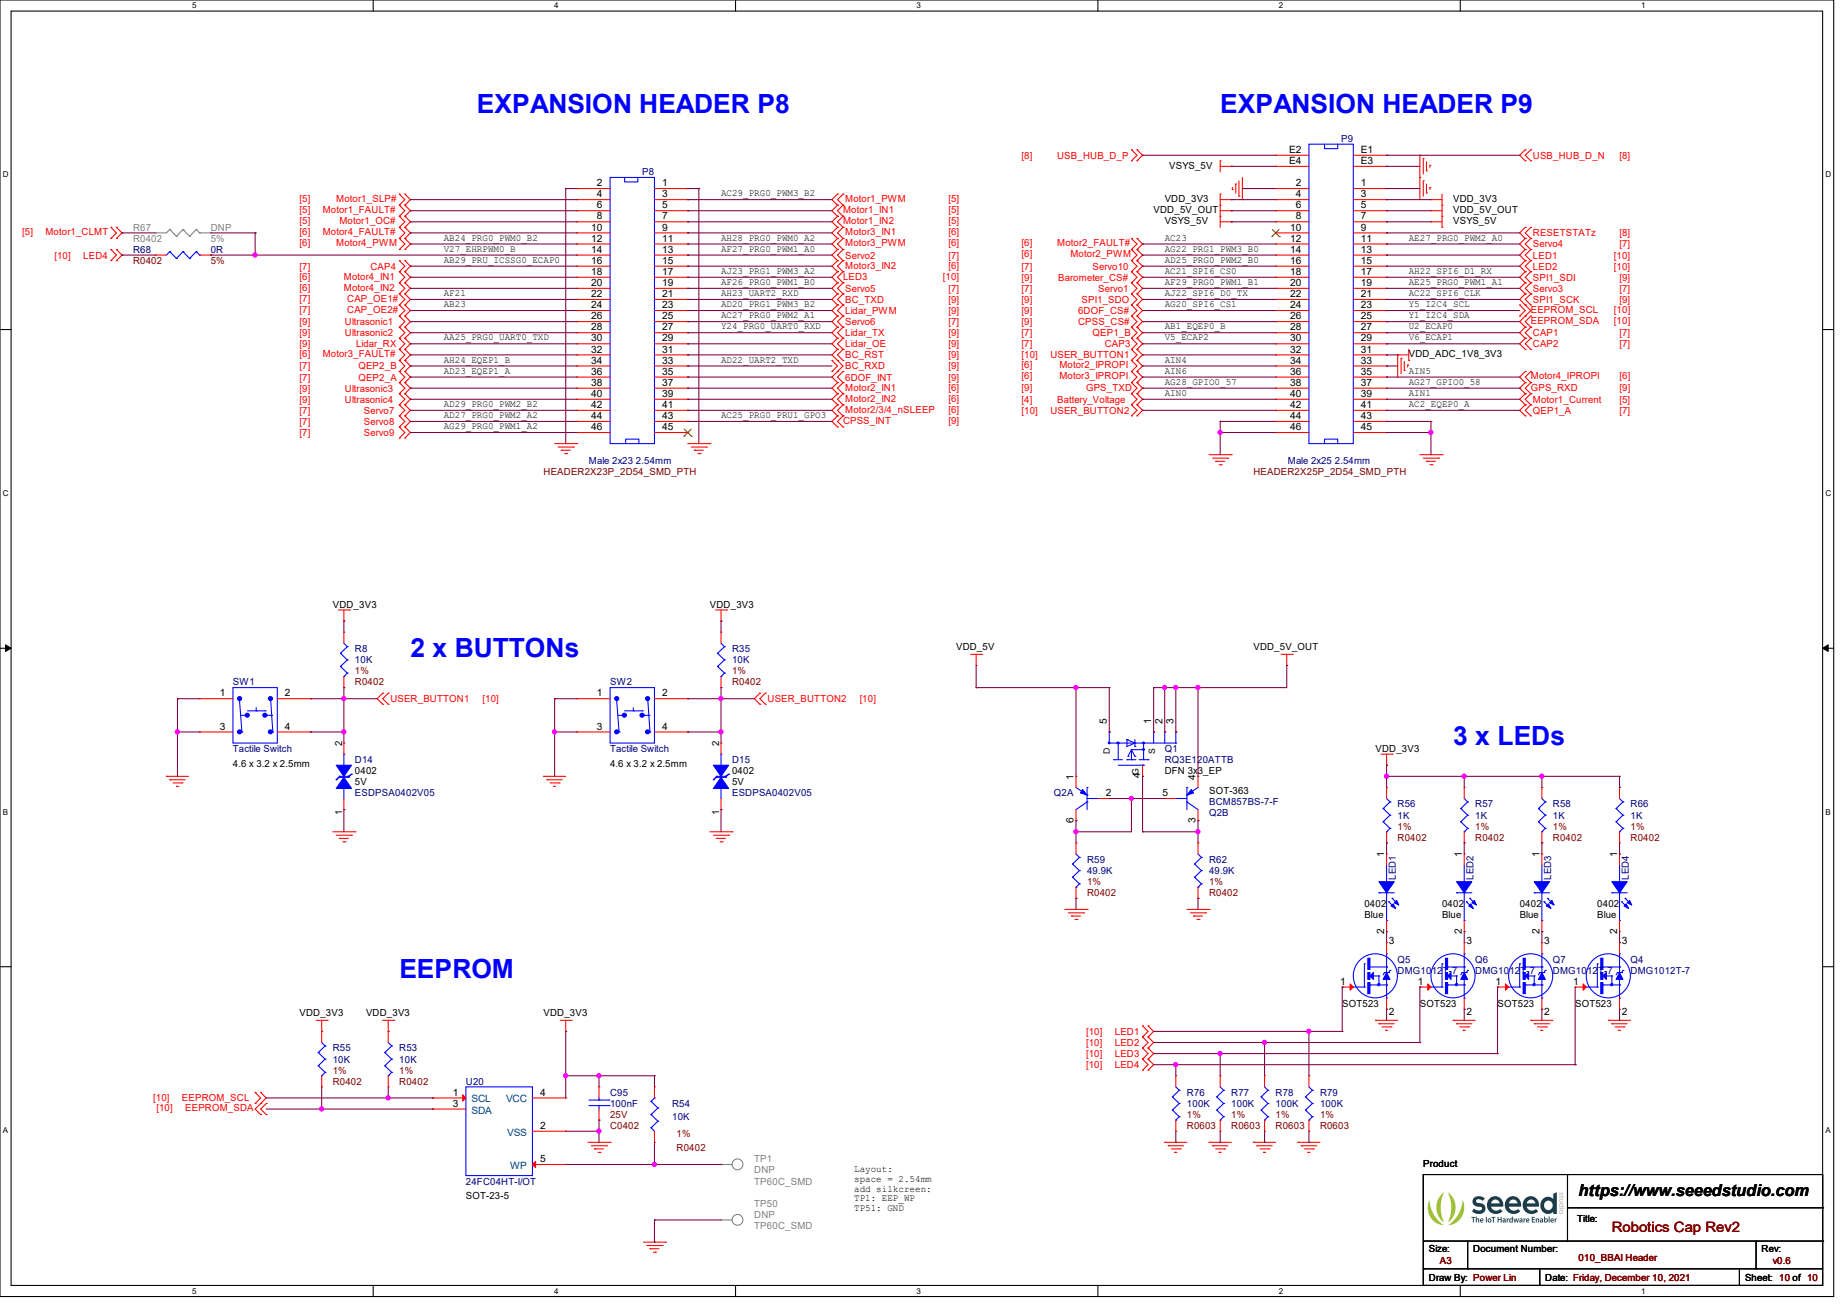
[picture p10: page 10]
