beagleboard/robotics-cape/(list of files, drawings)

Other design files:
Cape V0.6/Robotics Cape Rev2 v0.6.DSN
