beagleboard/robotics-cape/(commit log)

2021-11-23 silly script to help me remember the LED gpios
2022-03-08 Design files
    [Robotics Cape Rev2 v0.6.DSN]
